KentonSmith/ME_2011_Robot_Project/Robot_Pictures_2.pdf

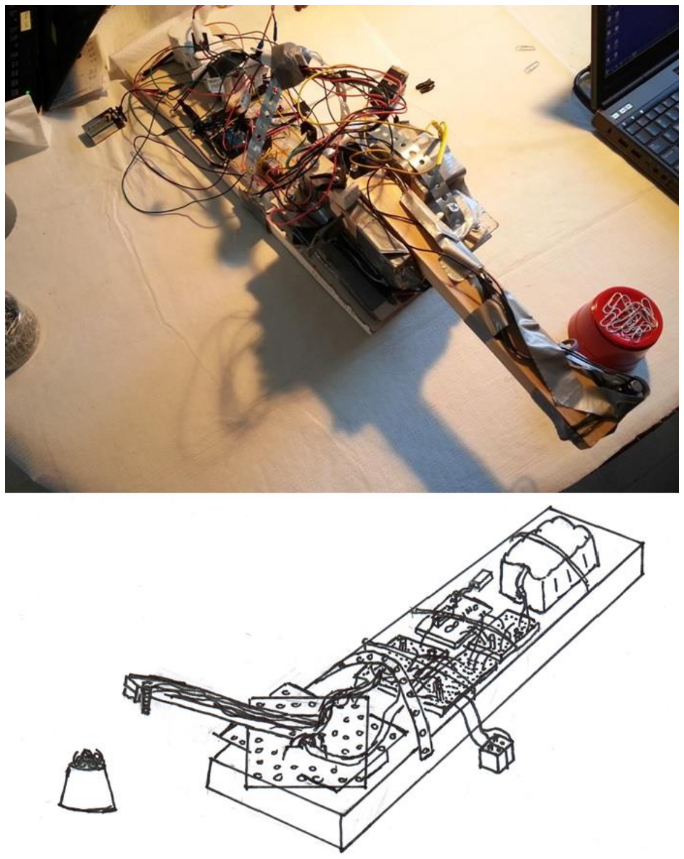
[picture p1: page 1]
