KentonSmith/ME_2011_Robot_Project/Infrared_Voltage_Reading.pdf

# IR Voltage Reading

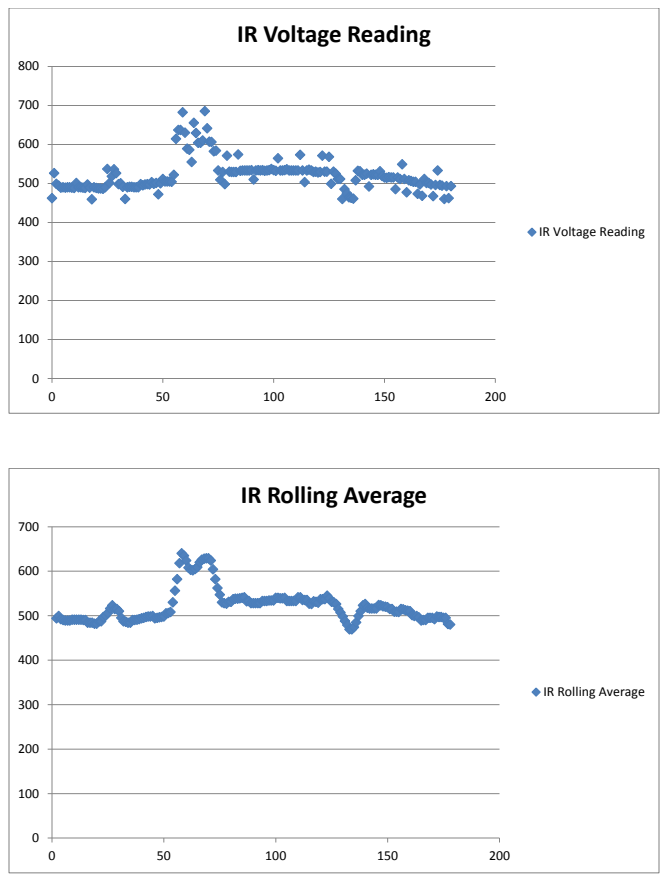
[picture p2: page 1]

IR Voltage Reading

IR Rolling Average
