KentonSmith/ME_2011_Robot_Project/Robot_Final_Circuit.pdf

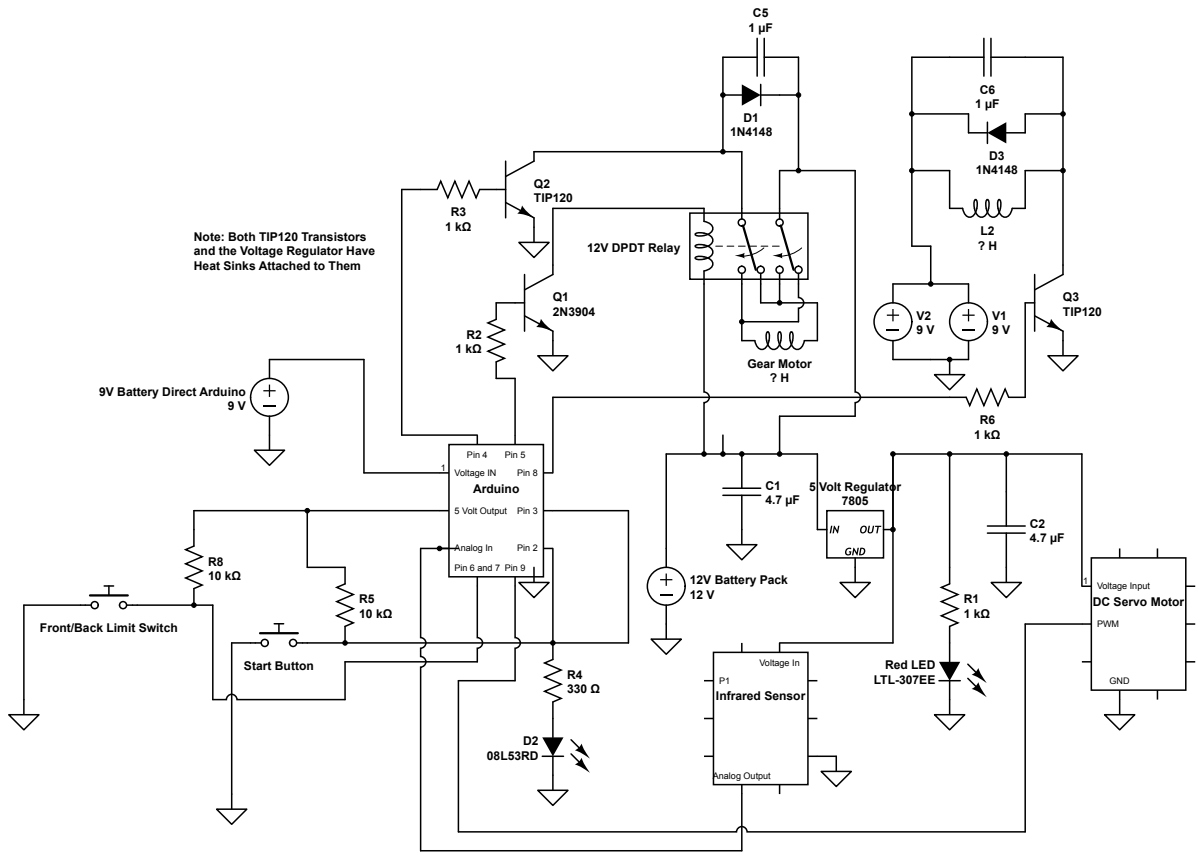
[picture p3: page 1]

Note: Both TIP120 Transistors
and the Voltage Regulator Have
Heat Sinks Attached to Them

Front/Back Limit Switch
